chcore11/ros2-mobile-robot-system/logs/2026-05-25-day35.md

# Day1 - Submission Repository Setup and Competition Material Organization

## Overview

Today started the first day of the competition submission repository.

Although the STM32-based AGV chassis project had already been developed for many days before this point, the previous work mainly focused on firmware bring-up, motor control, encoder reading, G474 migration, UART command control, and open-loop chassis testing.

The goal today was not to add new chassis functions. Instead, the focus was to create a clean and dedicated GitHub repository for the final competition submission.

This repository is separated from the daily development repository. Its purpose is to organize the final technical report, video script, source package notes, submission checklist, images, and stage logs in a way that is suitable for review and submission.

By the end of the day, the submission repository was able to:

- store competition-oriented documents separately
- keep submission materials away from temporary development files
- provide a clear README for the project
- organize technical documents under `docs/`
- organize final submission files under `submit/`
- reserve a place for firmware source and package notes
- reserve a place for project images and diagrams
- record the submission preparation process from Day1
- complete local Git initialization
- complete the first commit
- push the repository to GitHub successfully

This means the project has moved from pure development work to the first stage of competition material packaging.

## Main Work

### 1. Repository purpose definition

A dedicated repository was created for the competition submission.

The repository name is:

```text
stm32g4-agv-closed-loop-control
```

The Chinese project title is:

```text
基于STM32G4的AGV底盘闭环控制系统
```

The repository is not intended to replace the daily development repository.  
Its main role is to become the official material collection point for the competition.

The repository should mainly contain:

- technical report drafts
- submission checklist
- video script
- source package notes
- firmware package description
- hardware images
- system diagrams
- stage logs
- final deliverable preparation records

The repository should not contain:

- random temporary test files
- unorganized debug screenshots
- unrelated project files
- broken firmware folders
- unfinished experimental dumps without explanation

This distinction is important because a submission repository should be readable by judges, teachers, teammates, and future reviewers.

### 2. Local repository setup on Windows

The repository was created on the Windows D drive.

The local repository path is:

```text
D:\stm32g4-agv-closed-loop-control
```

This location was chosen to keep the submission repository independent from the WSL-based development workspace.

The local repository was then opened and managed through VS Code and Windows PowerShell.

This workflow is suitable for document organization because most submission files are Markdown documents, images, PDFs, and source package notes.

### 3. Directory structure creation

The first version of the repository structure was created.

Current structure:

```text
stm32g4-agv-closed-loop-control/
├── README.md
├── docs/
│   ├── hardware_design.md
│   ├── migration_f401_to_g474.md
│   ├── software_design.md
│   ├── technical_report_draft.md
│   ├── technical_report_outline.md
│   └── test_record.md
├── firmware/
│   ├── README.md
│   └── src_placeholder.md
├── logs/
│   └── day1_submission_repo_setup.md
├── submit/
│   ├── image_list.md
│   ├── source_package_note.md
│   ├── submission_checklist.md
│   └── video_script.md
└── assets/
    ├── diagrams/
    └── images/
```

The structure follows the final competition submission requirements.

The `docs/` directory is used for technical design and report documents.  
The `submit/` directory is used for files directly related to the final submission page.  
The `firmware/` directory is reserved for firmware source explanation and later source package organization.  
The `assets/` directory is used for images, diagrams, and visual materials.  
The `logs/` directory records the submission preparation process.

### 4. README initialization

The first version of `README.md` was created.

The README currently introduces:

- project name
- project background
- system purpose
- main project goals
- system components
- repository structure
- current project progress
- project keywords

The README is intentionally short and clear.

At this stage, the README should not be written like a long technical report.  
Its job is to help a reviewer understand the repository quickly.

The current README focuses on the following project identity:

```text
STM32G474RE + TB6612FNG + encoder differential chassis + speed feedback + AGV chassis control
```

This makes the project topic clear and avoids overclaiming features that are not yet finished.

### 5. Log numbering decision

Because this is a new submission repository, the log sequence starts from Day1.

This is different from the daily development log sequence.

The reason is that the repository has a new purpose and a new timeline:

- development repository: records engineering development progress
- submission repository: records competition material preparation

Therefore, even though the project itself has already gone through many development days, this repository starts from:

```text
Day1 - Submission Repository Setup
```

This keeps the submission timeline clean.

### 6. Git initialization and first commit

Git was initialized locally.

The first commit was completed with the commit message:

```text
docs: initialize submission repo day1
```

This commit included the initial directory structure and basic Markdown files.

The successful commit confirmed that the local repository was correctly initialized and ready to be connected to GitHub.

### 7. GitHub remote repository creation

A new GitHub repository was created under the account:

```text
chcore11
```

The remote repository name is:

```text
stm32g4-agv-closed-loop-control
```

The repository was created without adding an online README, `.gitignore`, or license file.

This avoided conflicts with the local repository, because the local repository already contained the initial README and commit history.

### 8. First push to GitHub

The local repository was connected to the GitHub remote repository.

The first push was completed successfully.

After pushing, the GitHub repository showed:

- `docs/`
- `firmware/`
- `logs/`
- `submit/`
- `README.md`

This confirmed that the local-to-remote workflow is working.

The repository is now ready for future updates through VS Code Source Control.

## Current Status

Completed:

- dedicated submission repository created
- Windows local repository created
- basic directory structure created
- README initialized
- Day1 log created
- local Git repository initialized
- first commit completed
- GitHub remote repository created
- first push completed
- repository visible on GitHub
- VS Code Source Control workflow confirmed as the preferred update method

Not completed yet:

- submission checklist content
- technical report outline
- technical report draft
- hardware design document
- software design document
- test record document
- F401 to G474 migration document
- video script
- source package note
- final firmware source package
- hardware images and diagrams
- final PDF technical report
- final competition upload package

## Important Problems Found

### 1. Submission repository must not become a trash folder

A dedicated submission repository is useful only if the content is controlled.

If all raw development files, temporary screenshots, test outputs, and unfinished materials are thrown into it, the repository will lose its value.

The submission repository must stay clean.

The current rule should be:

```text
Only put organized material into this repository.
```

### 2. Do not overclaim project progress

The project title is about an AGV chassis closed-loop control system.

However, the current development stage still needs more calibration and testing before the final closed-loop performance can be described confidently.

The documentation should avoid exaggerated statements.

Allowed:

- describe implemented modules
- describe current testing workflow
- describe planned closed-loop control
- describe known issues
- describe calibration needs

Not allowed:

- claim high precision without test data
- claim complete industrial AGV capability
- claim autonomous navigation if it is not implemented
- claim stable closed-loop performance before repeated testing

This is especially important for the technical report.

### 3. Submission material should follow the competition page

The competition page requires several deliverables, including:

- demonstration video
- technical document
- source code package
- authorization file
- repository link if needed
- board photos
- project keywords

Therefore, the repository structure should follow the final upload requirements instead of personal preference.

This is why the `submit/` directory was created early.

## Reflection

Today was not a firmware development day. It was a project packaging day.

This kind of work may look less exciting than making the car move, but it is necessary for a competition project.

A working chassis without clear documentation is hard to evaluate.  
A project with scattered files is hard to submit.  
A system without clean explanation is hard to trust.

The most important gain today was that the project now has a formal submission base.

From this point on, the competition materials can be built step by step instead of being rushed at the end.

Another important lesson is that development and submission are different workflows.

Development work allows temporary files, messy experiments, and frequent debugging.  
Submission work requires clarity, structure, and controlled claims.

The next stage should not be to blindly add more files.  
The next stage should be to fill the most important documents first.

## Next Step

The next practical goal is to complete the first version of the submission checklist and technical report outline.

Minimum target:

```text
submit/submission_checklist.md
docs/technical_report_outline.md
```

The checklist should map directly to the competition upload page.

The technical report outline should explain the system without inventing test data.

Suggested next commit:

```text
docs: add submission checklist and technical report outline
```

The project main line remains unchanged:

Do not treat the submission repository as a storage dump.  
Build a clean and reviewable competition package.

Stage conclusion:

Submission repository Day1 completed.

Next stage:

Submission checklist and technical report outline.
