chcore11/ros2-mobile-robot-system/logs/2026-04-23-day30.md

# Day30 - F401 Baseline Consolidation and Migration Draft Completion

## Summary

Today focused on consolidating the current project baseline rather than pushing new low-level features.

The main result of the day was completing the core documentation work that defines the current F401 validation stage and supports the next migration phase.

At this point, the project now has a clearer internal reference for:
- what the current F401 platform has already achieved
- how the current main program mainline works
- what key problems still exist
- what migration order should be followed when moving to STM32G474RE

This means the weekly responsibility on my side has been completed in a meaningful way.
The work this week was not only about coding, but about turning the current progress into a structured and reviewable engineering baseline.

## What was completed today

- Finished the first draft of the current F401 baseline document
- Clarified the current implemented abilities of the F401 platform
- Summarized the current known issues of the system
- Completed the main program mainline description based on the current `main.c`
- Finished the G474 migration order draft
- Confirmed the logic of treating F401 as the current validation baseline and G474 as the later migration target
- Checked part of the Nucleo-G474RE pin mapping relationship for later migration reference

## Main output of the day

The current documentation package now includes:

1. F401 baseline draft
2. program mainline description draft
3. known issues summary
4. G474 migration order draft

These outputs help turn the current project from "progress known mainly by myself" into "progress that can be explained, reviewed, and used by the team."

## Why this matters

This work is important because migration and collaboration become much easier once the current baseline is made explicit.

Without this step, later G474 bring-up and team collaboration would easily become chaotic:
- old problems may be mistaken as new ones
- current capabilities may be described differently by different people
- migration order may become unclear
- testing and verification may lose reference points

By writing these materials down, the current F401 stage is no longer only a running prototype.
It now has the beginning of an engineering reference framework.

## Current understanding

At the current stage:
- F401 remains the working baseline platform
- G474 migration should follow a staged order rather than immediate full transplantation
- the project now has a clearer software/documentation backbone for the next team phase

This week's work on my side can be considered complete.

## Reflection

Today did not mainly produce new hardware or control breakthroughs,
but it completed something equally necessary:
it converted scattered progress into structured project assets.

This is valuable because once a project starts involving multiple people,
clarity becomes part of engineering itself.

A baseline is not just a document.
It is a control point for migration, debugging, testing, and collaboration.

So today marks the completion of this week's responsibility on my side.

## Next step

- keep the current F401 baseline stable
- wait for the first round of outputs from other team members
- prepare for the next phase of G474-related bring-up and migration work
