chcore11/ros2-mobile-robot-system/logs/2026-04-23-day29.md

# Day29

## Summary

Today was a stage transition day for the project.

The biggest progress was not a technical feature itself, but a structural change in how the project will now move forward.
The project has officially shifted from a mostly single-person pushing mode into a clearer **3-person collaboration mode**.

At this point, the key issue is no longer only how to keep pushing the current F401-based prototype,
but how to organize responsibilities, reduce confusion, and prepare for the next engineering phase around the **STM32G474RE** competition platform.

## What was completed today

* Confirmed the purchase direction for the **STM32G474RE** competition board
* Clarified the difference between the current **F401 validation platform** and the future **G474 competition platform**
* Created a project group chat
* Published a formal group announcement for:

  * project responsibility structure
  * division of labor
  * weekly work arrangement
* Officially established a basic 3-person responsibility chain:

  * **I** take charge of system mainline, program mainline, integration and planning
  * **A** takes charge of hardware and migration-related work
  * **B** takes charge of testing records, documentation and presentation materials

## Why this matters

This is a real project milestone.

Previously, the project was mainly moving forward through individual effort:

* writing and modifying `main.c`
* solving wiring and power issues
* debugging motors, encoders and serial control
* pushing the system forward by direct hands-on work

Now the project has entered a different stage:

* responsibilities are no longer vague
* the team is no longer operating in an ad hoc way
* output expectations have started to become explicit
* project progress can begin to rely on collaboration rather than only individual load-bearing

That means the project is beginning to move from a **solo prototype mode** toward a more **organized engineering mode**.

## Current understanding

The immediate goal is still not to rush all unfinished work directly onto the G474 board.
The better strategy is:

* continue using **F401** as the current working and validation baseline
* let **G474** become the formal competition platform after bring-up and migration preparation
* keep the mainline clear before full migration
* reduce chaos by separating:

  * current baseline consolidation
  * hardware migration preparation
  * testing / documentation support

This keeps the project controllable.

## Team execution direction

The responsibility chain is now clearer:

### My role

* maintain the software and control mainline
* summarize the current F401 baseline
* define migration order
* organize and verify outputs

### Hardware / migration role

* prepare F401 vs G474 resource differences
* handle board-level bring-up and wiring migration
* support hardware readiness for future transition

### Testing / documentation role

* build testing records
  -整理实验数据与阶段材料
* support README, presentation and evidence collection

## Reflection

Today may look lighter in terms of direct coding output,
but it was still a meaningful breakthrough.

A project does not scale simply because more people join.
It only improves when:

* responsibilities are made explicit
* outputs are defined
* the mainline remains controlled
* collaboration reduces confusion instead of increasing it

So today marks a transition:
from “I am pushing the whole project forward alone”
to “the project is beginning to operate as a small team system.”

That is a genuine stage-level improvement.

## Next step

* start my own baseline-related work in the next two days
* organize:

  * current F401 baseline
  * program mainline logic
  * known issues
  * G474 migration order draft
* wait for the first round of output from the other two members
* keep the project moving from discussion into actual first-version delivery
