chcore11/ros2-mobile-robot-system/logs/2026-04-20-day27.md

# Day27

## Summary
Today I completed an important engineering upgrade for the STM32 mobile robot system.

The biggest improvement was not a new control algorithm, but a cleaner and more reliable experiment workflow.  
I replaced the previous two-file switching process (`clean main.c` + `run main.c`) with a single command-driven main program.

This significantly reduced repeated flashing operations and made testing much more stable and efficient.

## What was done
- Reviewed the previous offline record mechanism and confirmed that repeated flashing was causing too much friction
- Identified that the old workflow amplified download/debug chain instability
- Decided to merge all key functions into one main program instead of switching between multiple `main.c` files
- Designed a UART command interface:
  - `c` = clear flash record
  - `r` = read last record
  - `1~9` = wait 10 seconds, then run forward for N seconds and save the result
- Added a busy-state protection mechanism so that new commands are ignored while the robot is already executing a run
- Kept the existing motor control, encoder counting, odometry calculation, and Flash persistence logic inside the new unified program
- Successfully verified that:
  - command input works
  - delayed execution works
  - offline run works
  - record saving works
  - record readback works
  - record clearing works

## Key result
The robot can now be controlled through a single stable firmware program.

Instead of reflashing different test programs repeatedly, I can now:
- send a command from serial
- let the robot run offline after a 10-second delay
- reconnect later
- read back the saved result from Flash

This is a major workflow improvement.

## Experimental observations
- A 1-second command test was successfully executed
- The saved run record was correctly read back:
  - dA = 426
  - dB = 414
  - distA = 155 mm
  - distB = 150 mm
  - avg = 153 mm
- Flash clearing was also verified successfully:
  - after sending `c`, the system returned `No valid record in Flash.` when queried with `r`

## Why this matters
This upgrade reduced unnecessary operational complexity.

Previously, every new test required:
- reflashing a clean program
- reflashing a run program
- dealing with frequent flash/debug errors

Now the testing process is much closer to a real engineering toolchain:
- one firmware
- multiple commands
- lower risk of workflow mistakes
- better repeatability for experiments

## Current status
- Single-main command workflow: working
- UART command parsing: working
- delayed offline execution: working
- Flash save/read/clear: working
- repeated flashing dependency: greatly reduced

## Next step
- use the new command-based program for more structured experiments
- compare short-distance and long-distance behavior
- verify whether the front caster mainly affects the initial transient stage
- test whether longer runs show “initial deviation, then stable forward motion”
- continue refining straight-line performance and error analysis

## Reflection
Today was not about adding flashy new functions.  
It was about reducing system friction and making the whole experiment process more robust.

That is a meaningful engineering improvement.
