chcore11/ros2-mobile-robot-system/logs/2026-04-18-day25.md

# Day25

## Summary
Today I focused on recovering the STM32 flashing chain after repeated flash operation failures.

## What was done
- Installed STM32CubeProgrammer
- Connected successfully to NUCLEO-F401RE through ST-LINK
- Checked option bytes and confirmed no obvious RDP/WRP lock issue
- Performed mass erase successfully in STM32CubeProgrammer
- Restored CubeIDE download path
- Verified that downloading through ST-LINK works again (`Download verified successfully`)

## Current status
The board is no longer stuck in the previous flash operation failure state.
The flashing chain has been recovered.

## Next step
- Verify the minimal burn test program actually runs
- Check LD2 blinking
- Check UART output (`alive`)
- Then return to the robot control / Flash record integration work
