chcore11/ros2-mobile-robot-system/logs/2026-04-11-day18.md

# Day18 Log - First Practical Soldering and Hardware Bring-Up Initiation

## Summary
Today marked the first real soldering session in this project.

The most important result was that the LM2596 buck converter was successfully soldered and turned from a bare-hole module into a usable hardware component. Although the soldering quality was still rough, this session helped me build basic hands-on understanding of wire preparation, polarity awareness, hole-based module soldering, and practical connection logic.

This was not a full hardware integration day yet, but it was a meaningful transition from planning and temporary wiring into real physical system assembly.

## Work Done

### 1. LM2596 Soldering
- Prepared four wires for the buck converter:
  - `IN+`
  - `IN-`
  - `OUT+`
  - `OUT-`
- Used red wires for positive terminals and black wires for negative terminals
- Completed the first practical soldering of the LM2596 module
- Converted the module from a bare PCB part into a connectable power component

### 2. Basic Wiring and Soldering Practice
- Practiced:
  - cutting jumper wires
  - stripping wire insulation
  - distinguishing positive and negative connections
  - understanding input side vs output side of a buck converter
- Built a clearer understanding that hole-based modules require soldered wires instead of direct temporary insertion

### 3. Engineering Understanding Gained
- Confirmed that soldering quality still needs improvement
- Realized that “ugly solder joints” do not automatically mean failure, as long as:
  - the connection is conductive
  - the wire is mechanically stable
  - adjacent pads are not shorted
- Gained first-hand experience with practical hardware work instead of only planning at the document level

### 4. Issue Encountered
- Accidentally damaged part of the soldering iron cable insulation during the session
- Stopped treating the tool as fully safe for continued use before further checking
- Recognized that soldering is not only about making joints, but also about:
  - tool safety
  - workspace control
  - wire management

## Current Status
- LM2596 soldering is completed
- The buck converter is now ready for standalone input/output voltage testing
- Full power skeleton integration has not started yet
- Soldering skill is still at an early stage, but practical confidence is better than before

## What I Learned
- Bare-hole modules require real soldering, not temporary imagination-based wiring
- Clear red/black polarity conventions greatly reduce confusion
- Basic soldering workflow matters:
  - wire preparation
  - correct pad identification
  - stable soldering
  - post-checking
- Hardware work must include safety awareness, especially when using heated tools

## Next Step
- Test LM2596 with the 2-cell 18650 battery input
- Measure:
  - input voltage
  - output voltage
- Continue building the power supply skeleton after confirming the buck converter works properly
- Later move to:
  - battery power path
  - shared ground
  - TB6612 supply integration
