chcore11/ros2-mobile-robot-system/logs/2026-04-10-day17.md

# Day17 Log - Hardware Preparation and Component Familiarization

## Summary
Today was a preparation-focused work session.

No major firmware or hardware integration was completed, but I spent time getting more familiar with the current hardware components and the power-supply chain. This helped clarify the next practical step: real soldering and physical system bring-up.

## Work Done
### 1. Multimeter and Power Understanding
- Used the multimeter to measure battery voltage
- Confirmed that a single 18650 cell can read about 4.2V when fully charged
- Confirmed that the 2-cell battery box outputs about 8.4V, which means the cells are connected in series

### 2. Buck Converter Inspection
- Checked the buck converter module
- Confirmed that the module uses solder-through holes for `IN+`, `IN-`, `OUT+`, and `OUT-`
- Realized that proper wiring will require soldering instead of temporary loose insertion

### 3. Hardware Familiarization
- Reviewed the current components and their roles:
  - battery box
  - buck converter
  - TB6612 motor driver
  - STM32 controller board
  - multimeter
- Clarified the current hardware direction before formal wiring and soldering

## Current Understanding
- Battery box provides the main power source
- Buck converter will be used for voltage step-down
- TB6612 will use the external motor power path
- STM32 can temporarily remain on USB power during the early integration stage
- Proper common ground and reliable wiring will be important in the next stage

## Notes
Today was mainly about preparation, not formal integration.
The main value of today was reducing uncertainty before the upcoming soldering and hardware assembly work.

## Next Step
- Start soldering the required power connections
- Build the basic power distribution path
- Begin real hardware wiring and chassis-level integration
- Move from loose component understanding to actual system assembly
