chcore11/ros2-mobile-robot-system/logs/2026-03-27-day3.md

# Day3 - Serial Communication, Protocol Design and Initial Hardware Integration

## Overview

Day3 focused on building a complete bridge between PC software and embedded hardware.  
The goal was to move from isolated software development to an integrated system involving Python, serial communication, and Arduino.

This marks the first transition from "pure ROS2 simulation thinking" to "real-world control pipeline".

## Environment Setup (Python + VSCode)

- Installed Python 3.13 (64-bit) on Windows
- Configured PATH environment variable
- Verified installation using:
  - `python --version`
  - `pip --version`
- Installed required library:
  - `pyserial`

- Integrated Python with VSCode:
  - selected interpreter
  - executed scripts inside VSCode terminal
  - resolved path and working directory issues

## Result

- Python environment fully ready for serial communication
- Able to run and debug scripts efficiently in VSCode

## First Serial Communication (PC → Arduino)

- Wrote initial Python script:
  - continuously sends `"hello robot"`
- Configured serial parameters:
  - `COM3 @ 115200 baudrate`
- Verified successful transmission

## Result

- PC → Arduino one-way communication established

## Upgrade to Bidirectional Communication

Day3 then extended the system from simple one-way transmission to a command-response architecture.

### Arduino Side

- Implemented serial buffer reading
- Added command parsing:
  - `forward`
  - `back`
  - `left`
  - `right`
- Added response output:
  - `Serial.println("[ACK] ...")`
- Implemented string accumulation with newline termination

### Python Side

- Replaced loop sending with structured commands
- Added serial reading:
  - `ser.readline()`
- Added logging system:
  - `[SEND]`
  - `[RECV]`

## Result

- Full duplex communication achieved:

PC → Serial → Arduino → Response → PC

## Protocol Layer Design (Milestone)

The system evolved from:

raw string transmission

to:

structured command protocol

### Defined Protocol

- Commands:
  - `forward`
  - `back`
  - `left`
  - `right`
- Response format:
  - `[ACK] COMMAND`
- Unknown command handling:
  - `[ACK] UNKNOWN: xxx`

## Significance

- First implementation of a device communication protocol (`V0.1`)
- Built the foundation for future ROS2 → hardware interface

## System Validation

Performed structured validation of the communication pipeline.

### Cold Start Test

- Restarted the system and verified that communication still worked correctly

### Protocol Matching

- Confirmed that command-response mapping was accurate

### Stability Test

- Ran multiple tests without crash

### Error Case

- Encountered:
  - `"Access is denied"` on `COM3`

### Root Cause

- Arduino Serial Monitor was occupying the serial port

## Insight

- Serial port is a single-resource lock system
- Only one side can occupy the port at a time

## Interactive Control (WASD)

The Python script was further upgraded into interactive control mode.

### Input Mapping

- `w` → `forward`
- `a` → `left`
- `s` → `back`
- `d` → `right`

## Result

- Real-time manual control achieved
- The system became interactive instead of purely scripted

## Hardware Integration Attempt (LED Control)

### Goal

Map logical commands to physical outputs.

### Design

Used 4 LEDs to represent direction commands:

- `D2` → `forward`
- `D3` → `left`
- `D4` → `back`
- `D5` → `right`

### Arduino Implementation

- Added `pinMode()` initialization
- Added `digitalWrite()` control
- Added `resetLEDs()` to ensure only one direction LED was active at a time

### Issue Encountered

- LEDs did not light up as expected

### Root Causes

- Missing GND connection
- Circuit was not forming a closed loop
- Breadboard connection understanding was incomplete

## Insight

Hardware requires:

- a closed circuit loop
- correct GND reference
- proper breadboard wiring

## Current System Architecture

Keyboard Input  
→ Python (Command Mapping)  
→ Serial (`COM3`)  
→ Arduino (Parsing + Execution)  
→ Physical Output (LED, pending)  
→ Response (`ACK`)  
→ Python Output

## Key Achievements

- Built a complete PC ↔ Arduino communication pipeline
- Designed and implemented a basic protocol layer
- Transitioned from scripted control to interactive control
- Entered the hardware control domain
- Identified real hardware debugging issues

## What I Learned

- Serial communication fundamentals
- Importance of protocol abstraction
- Resource conflicts in hardware interfaces
- Difference between software bugs and hardware issues
- Basic circuit concepts:
  - GND
  - closed loop
  - breadboard structure

## Current Status

- Communication Layer: Stable
- Protocol Layer: Defined
- Control Logic: Working
- Hardware Layer: Not yet stable

## Next Step (Day4)

- Fix GND connection on breadboard
- Validate single LED circuit
- Expand to 4 LEDs
- Complete WASD → LED mapping
- Stabilize the hardware execution layer

## Summary

Day3 represents a major transition from:

software-only development

to:

integrated system development (software + embedded hardware)

This was the first real step toward building a practical robot control pipeline.
