chcore11/ros2-mobile-robot-system/logs/2026-04-09-day16.md

# Day16 Log - Light Documentation Cleanup

## Summary
Today was a light maintenance day. After physical activity and general fatigue in the evening, I did not continue heavy development work. Instead, I spent some time doing basic document整理 and keeping the project rhythm continuous.

## Work Done
### 1. Light Documentation Cleanup
- Reviewed part of the recent project notes
- Did some simple document organization
- Kept the repository context clearer for the next development session

### 2. Maintained Project Continuity
- No new firmware feature was added today
- No new debugging or hardware test was performed
- The main goal today was simply to avoid breaking the workflow and to keep the project moving steadily

## Current Project State
- Dual motor drive: available
- Dual encoder interrupt counting: available
- Fixed-period speed feedback: available
- Basic open-loop consistency compensation: verified
- Motion-control interface: not started yet
- Closed-loop speed control: not started yet

## Notes
Today’s work was intentionally light. Although there was no major implementation progress, the project rhythm was preserved through low-load maintenance work. This kind of small continuation is still valuable because it helps reduce restart cost for the next session.

## Next Step
- Build the minimal chassis motion interface:
  - forward
  - backward
  - left
  - right
  - stop
- Then continue toward cleaner motion control structure before attempting closed-loop control
