chcore11/ros2-mobile-robot-system/logs/2026-04-05-day12.md

# Day12 Log - Dual Motor Bring-up and Chassis Control Layer Start

## Summary

Today I completed one of the most important transitions in this project:

**from single-motor debugging to dual-motor chassis bring-up**

This means the system is no longer just testing isolated components.  
It has now entered the stage of **real mobile robot chassis control**.

---

## Work Done

### 1. Dual Motor Bring-up Completed

Today I successfully completed the basic integration of:

- STM32
- TB6612FNG
- dual DC motors
- differential-drive chassis motion

The robot chassis can now perform:

- forward
- backward
- left turn
- right turn
- stop

This marks the first successful bring-up of the embedded execution layer.

---

### 2. B Channel Debugging and Pin Mapping Issues Resolved

A large part of today's work focused on debugging the B motor channel.

During this process, I identified several important engineering issues:

- MCU pin name is not equal to board silk label
- PB0 corresponds to **A3**
- PB1 is not available on the normal Arduino-style pin row
- PB5 was later selected as a better replacement for BIN2
- wrong pin assumptions can directly cause abnormal motor behavior

This debugging process helped clarify a very important embedded principle:

> software pin naming, board header mapping, and actual wiring location must be treated separately

---

### 3. Motor Direction and Turning Behavior Adjusted

After the dual motor system was brought up, I further adjusted:

- motor direction definitions
- left/right wheel motion logic
- turning behavior
- speed constants

Key findings:

- too small duty values may not overcome motor start threshold
- turning is not just “one wheel slow” in theory, but also depends on whether the wheel can physically start under load
- B motor forward/reverse logic may need to be inverted depending on actual wiring and wheel orientation

This moved the project from “it can move” toward “it can move correctly”.

---

### 4. Control Layer Introduced

Today was not only about motion bring-up.

I also began moving from:

**fixed autonomous motion sequence**

to:

**external command-based control**

A serial-control structure was introduced conceptually and then implemented in software, with command mapping such as:

- `w` -> forward
- `s` -> backward
- `a` -> left
- `d` -> right
- `x` -> stop

This marks the beginning of the **control layer** above the execution layer.

---

### 5. Power and System Stability Issues Exposed

Today’s debugging also exposed an important reality of real embedded systems:

many failures were not caused by logic errors, but by physical-layer problems such as:

- loose battery contacts
- unstable Dupont wiring
- poor pin mapping assumptions
- weak startup torque at low duty

This is actually a major project milestone, because it means the work has moved beyond “code only” and into **real hardware-system debugging**.

---

## Key Outcomes

By the end of today, the project achieved:

- dual motor independent control
- chassis forward/backward/turning capability
- first working control-layer structure
- improved understanding of motor startup thresholds
- clearer STM32 pin mapping awareness
- better separation of software logic vs physical wiring issues

---

## Engineering Significance

Today’s result is not just that “two motors can spin”.

The real significance is:

> the project now has a controllable embedded mobile chassis foundation

This is the minimum viable base required for all future work, including:

- remote control
- encoder feedback
- closed-loop speed control
- odometry
- competition-oriented AGV demo
- later ROS2 host-side integration

---

## Current Project Status

The project has now entered a new stage:

**Execution layer: basically brought up**  
**Control layer: started**  
**Feedback layer: next main target**

This means the next major work should focus on:

- stable power solution
- encoder access
- wheel speed feedback
- basic closed-loop control preparation

---

## Next Step

### Short-term next tasks

- stabilize chassis power system
- finalize reliable dual-motor control behavior
- prepare encoder wiring and signal reading
- continue improving control layer structure

### Main technical direction

Move from:

**open-loop motion**
to:
**feedback-based chassis control**

---

## Reflection

Today was a true system integration day.

I spent much less time on abstract logic and much more time on:

- wiring verification
- real hardware behavior
- signal mapping
- physical debugging
- control-response observation

This is exactly the kind of engineering transition this project needed.

The system is no longer a simple motor experiment.

It is now becoming a real embedded robot chassis platform.
