chcore11/ros2-mobile-robot-system/logs/2026-04-01-day8.md

# Day8 Log - Debug Reflection and Engineering Direction Adjustment

## Summary
Today I paused hardware debugging and used the session to reflect on both the motor issue and the broader engineering path ahead. The main goal was not to force progress under poor condition, but to clarify the real problems, reassess priorities, and extract useful conclusions for the next stage.

## Context
Several factors affected today's work quality:
- Poor physical state after failing to nap at noon
- Frustration caused by the unresolved motor debugging issue
- Reflection triggered by external feedback on the feasibility of directly contacting higher-level labs for internship opportunities

Given these conditions, continuing hardware trial-and-error was unlikely to produce high-quality results. The decision was made to stop motor debugging temporarily and instead focus on understanding the deeper issues behind both the technical bottleneck and the career path question.

## Work Done
### 1. Reassessed the motor debugging situation
Reviewed the current motor test status:
- Wiring and control chain are structurally close to complete
- The motor produced a slight sound when powered, which suggests the system is not fully dead
- The current issue is more likely related to power delivery, startup torque, or hardware-level constraints rather than a completely incorrect overall structure

Conclusion:
- The motor problem should be treated as a layered engineering debugging task
- Further debugging will continue tomorrow with a clearer and more controlled process

### 2. Reflected on current engineering weaknesses
Based on today's discussion, identified that the real gap is not just "building systems," but:
- Debug capability
- Engineering robustness
- Reliability of output
- Depth of understanding behind design choices

This led to a clearer distinction between:
- Making something run once
- Building something stable, explainable, and reusable

### 3. Reframed the internship/lab-entry problem
Analyzed the problem from both sides:

From my side:
- I want a real internship/research experience
- I want exposure to higher-level projects
- I want to prove I can contribute meaningful work

From a lab/teacher side:
- They want low-risk, reliable, and manageable students
- They want someone who can reduce workload rather than create more of it
- They need stable people who can continue working and gradually become productive

Conclusion:
- Entering a stronger lab is not only about enthusiasm or having a basic project
- What matters is whether I can provide stable and reliable productivity

### 4. Adjusted the strategy for the next stage
The previous mindset was too close to:
- "Try to contact a stronger lab directly and hope for an opportunity"

Today's adjustment is:
- First become a person worth taking in
- Strengthen engineering depth and reliability
- Prioritize building real productivity and trust
- Focus more realistically on local/project-based opportunities first, while keeping stronger external platforms as a medium-term goal

## Key Learnings
### 1. Debug ability is a core engineering skill
Engineering value is not only in building a system, but in being able to:
- Localize problems
- Control variables
- Separate layers
- Turn vague symptoms into concrete evidence

### 2. Robustness matters more than surface completion
A system that "runs once" is not enough.
A stronger project should be:
- Reproducible
- Stable
- Clearly documented
- Understandable to others

### 3. Reliable output is highly valuable
For labs and teams, reliability includes:
- Consistent progress
- Task closure
- Clear reporting
- Low management cost
- Long-term stability

### 4. Career planning should be based on supply-demand logic
Instead of only asking what I want, I should also ask:
- What kind of person does a lab actually want?
- What abilities are scarce and valuable?
- What can I realistically offer right now?

## Current Status
- Hardware debugging is temporarily paused
- The motor issue remains unresolved, but the next debugging direction is clearer
- Strategic understanding of engineering growth and lab-entry requirements improved significantly
- The main focus going forward is shifting from "just building projects" to "building dependable engineering ability"

## Next Step
### Technical
- Resume motor debugging tomorrow
- Continue with layered diagnosis:
  - power delivery
  - driver behavior
  - contact reliability
  - execution chain verification

### Growth Direction
- Strengthen debug methodology
- Improve engineering robustness
- Continue building stable project output
- Treat local project/lab opportunities as the primary path to accumulate stronger evidence and credibility

## Conclusion
Today was less about technical progress and more about correcting mindset and direction.
The main outcome is a clearer understanding that future opportunities depend not only on project existence, but on whether I can become a stable, reliable, and low-risk contributor with real engineering value.
