chcore11/ros2-mobile-robot-system/logs/2026-03-29-day5.md

# Day5 - STM32 Environment Setup & Project Initialization (Preparation Phase)

## What I did

* Installed STM32CubeIDE (v2.11 Latest)
* Completed driver installation:

  * ST-LINK drivers
  * ST-LINK server
* Successfully launched STM32CubeIDE and configured workspace
* Created first STM32 project environment (initial attempt)
* Identified difference between:

  * Empty Project (manual configuration)
  * CubeMX-based Project (recommended for beginners)
* Confirmed correct board selection workflow:

  * Board Selector → NUCLEO-F401RE

## Current Status

* Development environment: READY
* Toolchain & drivers: VERIFIED
* STM32 board: AVAILABLE but not yet connected (no Mini USB cable)
* Project structure: INITIALIZED

## Key Insights

* STM32 development is NOT like Arduino
* Project type selection is critical:

  * CubeMX project enables graphical configuration (GPIO, clock, peripherals)
* Board-level selection is more suitable than MCU-level for beginners
* Environment preparation significantly reduces future debugging cost

## Limitations Today

* Unable to proceed with:

  * Powering the board
  * Flashing firmware
  * Running hardware tests

Reason:

* Mini USB data cable not yet available

## Plan for Next Day (Day6)

* Connect NUCLEO-F401RE via Mini USB
* Create CubeMX-based project (correct workflow)
* Configure GPIO for onboard LED
* Generate code
* Build & flash firmware
* Achieve first hardware milestone:
  → Onboard LED blinking

## Summary

Day5 focused on environment setup and workflow understanding.

Although no hardware execution was performed,
the entire STM32 development pipeline is now ready.

This ensures a smooth transition into real embedded development in Day6.
