chcore11/ros2-mobile-robot-system/logs/2026-03-28-day4.md

# Day4 - Execution Layer Prototype Completed (Arduino Phase)

## What I did

* Completed LED-based actuator system using Arduino
* Built full hardware control loop:

  * WASD input → Python → Serial → Arduino → GPIO → LED output
* Fixed critical hardware issues:

  * GND connection (common ground)
  * circuit closure (loop completion)
  * breadboard structure understanding
* Verified stable bidirectional communication:

  * command sending (forward / left / right / back)
  * ACK response from Arduino
* Established basic control logic:

  * direction mapping to physical output (LED)
  * reset mechanism to ensure single active direction

## Key Results

* First successful end-to-end hardware control pipeline
* Transition from "demo-level blinking" to "control system prototype"
* Execution layer concept validated (software → hardware action)

## Insights

* Hardware requires strict circuit closure (GND loop)
* Breadboard structure is non-trivial (rows vs split middle)
* Serial communication must handle resource locking (COM port)
* Debugging hardware is fundamentally different from software

## System Architecture (Current)

Keyboard Input
→ Python (Command Mapping)
→ Serial Communication (COM3)
→ Arduino (Command Parsing)
→ GPIO Output
→ LED (Actuator Simulation)
→ ACK Feedback

## Current Status

* Communication Layer: Stable
* Protocol Layer: Basic version established
* Control Logic: Working
* Hardware Layer: Verified (LED control)

## Next Step (Day5)

* Transition from Arduino → STM32 (Nucleo-F401RE)
* Rebuild execution layer using STM32:

  * GPIO output
  * UART communication
* Prepare for motor control (PWM)

## Summary

Day4 marks the completion of the first real hardware control loop.

This represents the transition from:
software-level experimentation
to
hardware-integrated control system

The execution layer foundation is now ready for STM32 migration.
