chcore11/ros2-mobile-robot-system/logs/2026-03-25-day1.md

# 2026-03-25 (Day1)

## What I did
- Initialized the second-stage project repository: `ros2-mobile-robot-system`
- Created the basic engineering folder structure
- Added initial project files:
  - `README.md`
  - `PROGRESS.md`
  - `.gitignore`
- Defined the project direction clearly:
  - From ROS2 simulation-based navigation
  - To ROS2 + embedded system integration
- Set the first practical target of this repository:
  - ROS2 → Serial → Arduino Uno R3 → Basic response
- Connected the local repository to GitHub
- Pushed the initial project structure to remote

## Project Positioning
This repository is the continuation of the previous project `ros2-nav-learning`.

The first repository focused on:
- ROS2 navigation in simulation
- SLAM, AMCL, Nav2
- TF and system-level understanding

This new repository focuses on:
- Bridging ROS2 with embedded hardware
- Building the execution-layer foundation of a mobile robot system
- Preparing for future motor control and odometry feedback

## Current Goal
The current goal is not to build the full robot immediately.

Instead, the first step is:
- Establish the repository structure
- Set up a clean project roadmap
- Prepare for ROS2 ↔ Arduino serial communication

## Notes
This marks the beginning of Stage 2:
from simulation-based navigation
to real-world robot system integration.

## Git Update
git add .
git commit -m "Day1: initialize ROS2 mobile robot system repository"
git push
