chcore11/ros2-mobile-robot-system/docs/week1.md

# Weekly Review Template

## 1. This Week Target
- F401 baseline documentation
- Main program mainline explanation
- G474 migration draft
- F401 vs G474 resource comparison draft
- Test record / issue tracking template

## 2. Member Output Review

| Member | Expected Output | Submitted | Problem | Next Action |
|---|---|---|---|---|
| Chung | F401 baseline, mainline summary, migration draft | Yes | - | Prepare next week plan |
| 罗文杰 | F401 vs G474 resource comparison draft | Pending | - | Review on Sunday |
| 谢书畅 | Test record / issue template | Pending | - | Review on Sunday |

## 3. Review Questions
- Did each member produce a visible output?
- Is the output usable for the next stage?
- Are there any unclear task boundaries?
- What problems appeared during collaboration?
- What should be continued next week?
- What should be adjusted next week?

## 4. Next Week Planning Draft
Possible next week focus:
- G474 board bring-up preparation
- F401 vs G474 resource comparison refinement
- CubeMX project preparation for G474
- Migration risk list
- Test record standardization
- F401 baseline stability maintenance

## 5. Rule
A weekly task is only considered completed if it produces one of the following:
- document
- table
- test record
- code result
- verified conclusion
