chcore11/ros2-mobile-robot-system/(commit log)

2026-03-25 Add .gitkeep to track empty directories
2026-03-26 feat: add serial communication module (Python sender + Arduino receiver)
2026-03-27 feat(serial): implement bidirectional serial protocol (Day3.75)
    - Arduino now parses incoming commands (forward/stop/left/right)
    - Python sends structured commands instead of raw strings
    - Added serial response handling (ACK messages)
    - Established basic communication protocol between Python and Arduino
    This upgrades communication from one-way to bidirectional interaction.
2026-03-28 feat(execution): complete Arduino-based actuator prototype and prepare for STM32 transition (Day4) - implemented LED-based execution layer - validated full control pipeline (PC → Serial → Arduino → G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
2026-03-29 feat(stm32): setup STM32CubeIDE environment and initialize project workflow
    - installed STM32CubeIDE v2.11
    - configured workspace and drivers (ST-LINK)
    - explored project creation flow
    - identified CubeMX vs empty project difference
    - prepared for hardware bring-up (Day6)
2026-03-30 day6: add stm32 f401 led blink project
2026-03-30 day6.75: stm32 button-controlled led toggle
2026-03-31 Day7: PWM control completed, initial TB6612 integration attempted, motor not yet rotating
2026-04-03 docs: refactor README and PROGRESS for competition track
2026-04-03 docs(log): add Day10 motor debug log
2026-04-04 feat: single motor bring-up completed
2026-04-05 docs: add Day12 log for dual motor bring-up and control layer start
2026-04-06 log: add Day13 dual encoder serial monitoring progress
2026-04-07 log: add Day14 encoder polling optimization verification
2026-04-08 feat: add EXTI encoder feedback and fixed-period speed monitoring
2026-04-11 log: add Day18 hardware bring-up and first soldering session
2026-04-12 log: add Day19 full offline power bring-up breakthrough
2026-04-13 log: add Day20 encoder integration progress
2026-04-14 log: add Day21 encoder debug and signal isolation assessment
2026-04-15 log: add Day22 GPIO fix and B motor output debug
2026-04-16 log: add Day23 dual motor recovery and encoder monitor restore
2026-04-17 log: add Day24 encoder validation and open-loop wheel speed alignment
2026-04-18 day25: recover stm32 flashing chain
2026-04-20 day27: merge clean/run workflow into single UART command-based main program
2026-04-26 complete G474 motor driver bring-up
2026-04-27 complete G474 open-loop chassis control v1
