chcore11/ros2-mobile-robot-system/(notices)

Notices in the files:
README.md:
License: MIT
